VIP-LES/leos-ground-station-pcb/LEOS-ground-station.kicad_pcb

## KiCad design LEOS-ground-station.kicad_pcb (2026-10-07)

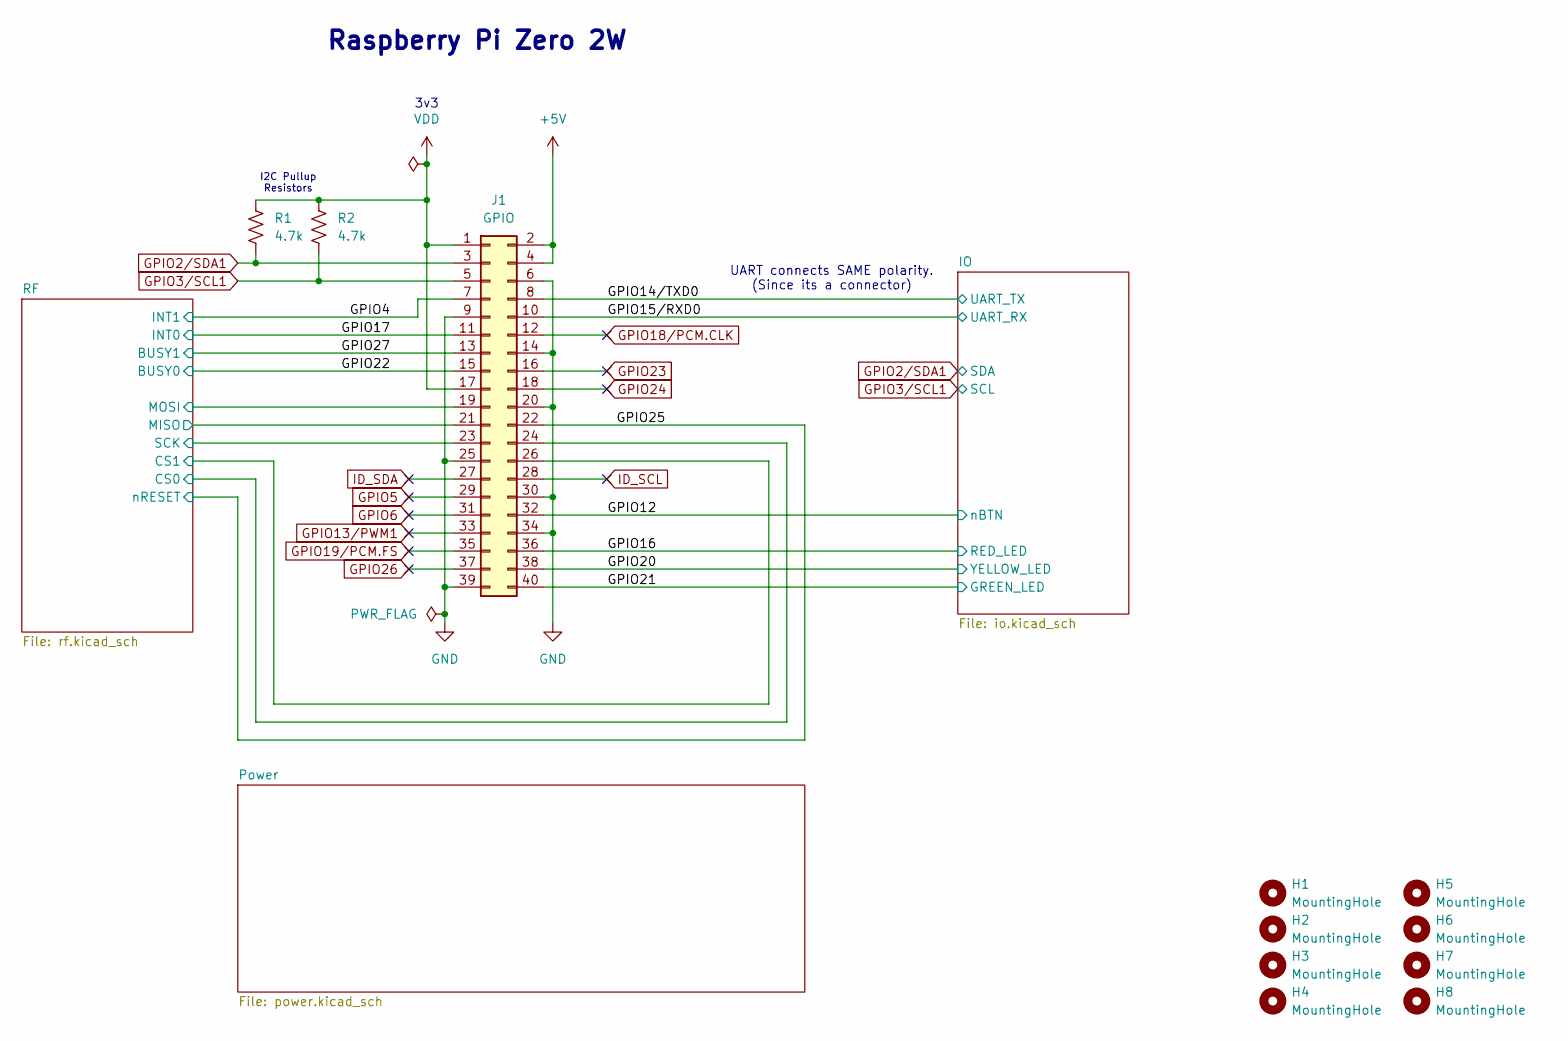
[picture p1: schematic LEOS-ground-station.kicad_sch, LEOS Ground Station]

Parts:
H1, H2, H3, H4: MountingHole; MountingHole_2.7mm_M2.5
H5, H6, H7, H8: MountingHole; MountingHole_3.2mm_M3
J1: GPIO; PinSocket_2x20_P2.54mm_Vertical
R1, R2: 4.7k; R_0805_2012Metric; MPN CRCW08054K70FKEA; Digikey 541-4.70KCCT-ND

Connections:
+5V: J1.2, J1.4; also elsewhere on the board
/GPIO4: J1.7; also elsewhere on the board
/GPIO12: J1.32; also elsewhere on the board
/GPIO14/TXD0: J1.8; also elsewhere on the board
/GPIO15/RXD0: J1.10; also elsewhere on the board
/GPIO16: J1.36; also elsewhere on the board
/GPIO17: J1.11; also elsewhere on the board
/GPIO20: J1.38; also elsewhere on the board
/GPIO21: J1.40; also elsewhere on the board
/GPIO22: J1.15; also elsewhere on the board
/GPIO25: J1.22; also elsewhere on the board
/GPIO27: J1.13; also elsewhere on the board
/RF/CS0: J1.24; also elsewhere on the board
/RF/CS1: J1.26; also elsewhere on the board
/RF/MISO: J1.21; also elsewhere on the board
/RF/MOSI: J1.19; also elsewhere on the board
/RF/SCK: J1.23; also elsewhere on the board
GND: J1.6, J1.9, J1.14, J1.20, J1.25, J1.30, J1.34, J1.39; also elsewhere on the board
GPIO2/SDA1: J1.3, R1.2; also elsewhere on the board
GPIO3/SCL1: J1.5, R2.2; also elsewhere on the board
GPIO5: J1.29
GPIO6: J1.31
GPIO13/PWM1: J1.33
GPIO18/PCM.CLK: J1.12
GPIO19/PCM.FS: J1.35
GPIO23: J1.16
GPIO24: J1.18
GPIO26: J1.37
ID_SCL: J1.28
ID_SDA: J1.27
VDD: J1.1, J1.17, R1.1, R2.1; also elsewhere on the board

Notes on the sheet:
3v3
Raspberry Pi Zero 2W
I2C Pullup Resistors
UART connects SAME polarity. (Since its a connector)

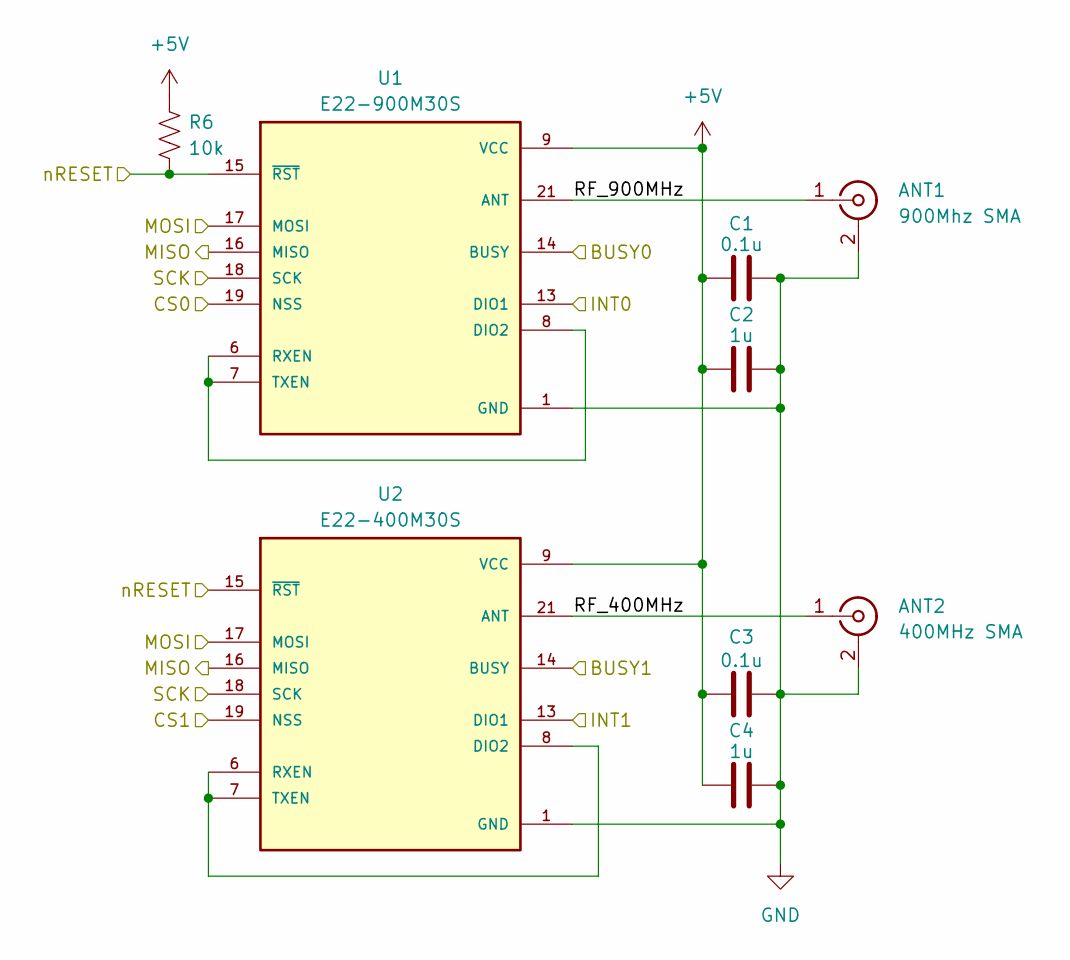
[picture p2: schematic rf.kicad_sch]

Parts:
ANT1: 900Mhz SMA; SMA_Molex_73251-1153_EdgeMount_Horizontal; MPN 0732511153; Digikey 900-0732511153-ND
ANT2: 400MHz SMA; SMA_Molex_73251-1153_EdgeMount_Horizontal; MPN 0732511153; Digikey 900-0732511153-ND
C1, C3: 0.1u; C_0603_1608Metric; MPN CL10B104KB8NNNL; Digikey 1276-CL10B104KB8NNNLCT-ND
C2, C4: 1u; C_0603_1608Metric; MPN CL10B105KA8NNNC; Digikey 1276-1184-1-ND
R6: 10k; R_0805_2012Metric; MPN CRCW080510K0FKEA; Digikey 541-10.0KCCT-ND
U1: E22-900M30S; XCVR_E22-900M30S; MPN E22-900M30S
U2: E22-400M30S; XCVR_E22-900M30S; MPN E22-400M30S

Connections:
+5V: C1.1, C2.1, C3.1, C4.1, R6.1, U1.9 (VCC), U1.10 (VCC), U2.9 (VCC), U2.10 (VCC); also elsewhere on the board
/GPIO4: U2.13 (DIO1); also elsewhere on the board
/GPIO17: U1.13 (DIO1); also elsewhere on the board
/GPIO22: U1.14 (BUSY); also elsewhere on the board
/GPIO25: R6.2, U1.15 (~RST), U2.15 (~RST); also elsewhere on the board
/GPIO27: U2.14 (BUSY); also elsewhere on the board
/RF/CS0: U1.19 (NSS); also elsewhere on the board
/RF/CS1: U2.19 (NSS); also elsewhere on the board
/RF/MISO: U1.16 (MISO), U2.16 (MISO); also elsewhere on the board
/RF/MOSI: U1.17 (MOSI), U2.17 (MOSI); also elsewhere on the board
/RF/RF_400MHz: ANT2.1 (In), U2.21 (ANT)
/RF/RF_900MHz: ANT1.1 (In), U1.21 (ANT)
/RF/SCK: U1.18 (SCK), U2.18 (SCK); also elsewhere on the board
GND: ANT1.2 (Ext), ANT2.2 (Ext), C1.2, C2.2, C3.2, C4.2, U1.1 (GND), U1.2 (GND), U1.3 (GND), U1.4 (GND), U1.5 (GND), U1.11 (GND), U1.12 (GND), U1.20 (GND), U1.22 (GND), U2.1 (GND), U2.2 (GND), U2.3 (GND), U2.4 (GND), U2.5 (GND), U2.11 (GND), U2.12 (GND), U2.20 (GND), U2.22 (GND); also elsewhere on the board
unnamed: U1.6 (RXEN), U1.7 (TXEN), U1.8 (DIO2)
unnamed: U2.6 (RXEN), U2.7 (TXEN), U2.8 (DIO2)

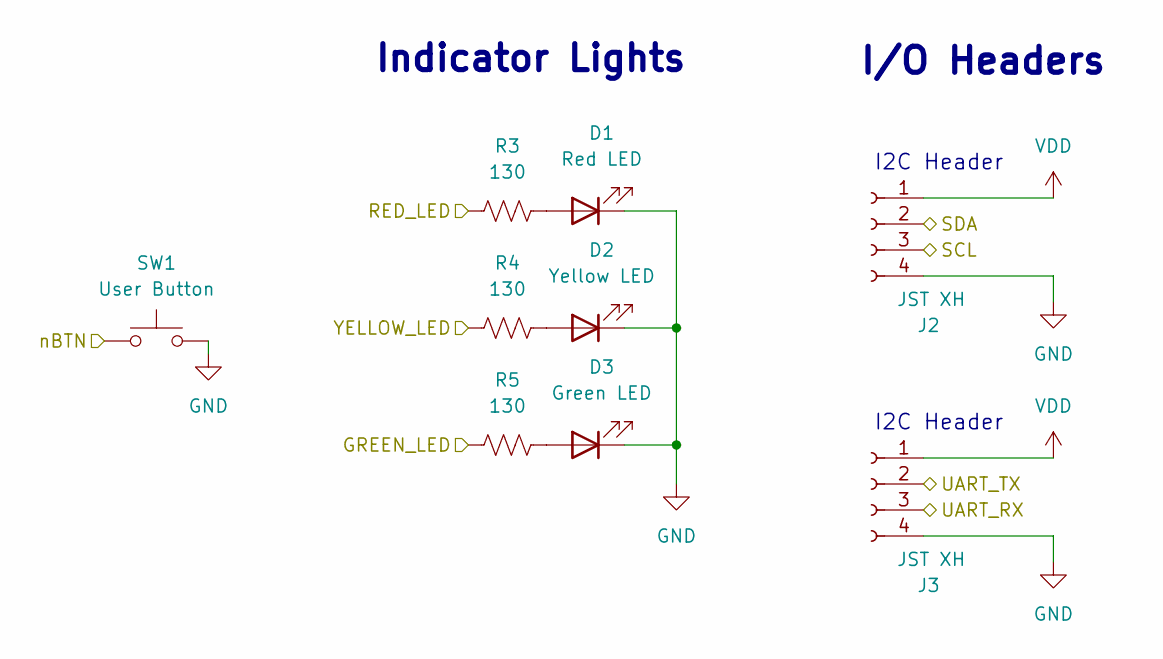
[picture p3: schematic io.kicad_sch]

Parts:
D1: Red LED; LED_1206_3216Metric; MPN LTST-C150KRKT; Digikey 160-1405-1-ND
D2: Yellow LED; LED_1206_3216Metric; MPN LTST-C150KSKT; Digikey 160-1406-1-ND
D3: Green LED; LED_1206_3216Metric; MPN LTST-C230KGKT; Digikey 160-1456-1-ND
J2, J3: JST XH; JST_XH_S4B-XH-A_1x04_P2.50mm_Horizontal; MPN S4B-XH-A; Digikey 455-2243-ND
R3, R4, R5: 130; R_0805_2012Metric; MPN CRCW0805130RFKEA; Digikey 541-130CCT-ND
SW1: User Button; SW_PUSH_6mm; MPN PTS645SK50-2 LFS; Digikey CKN9082-ND

Connections:
/GPIO12: SW1.1; also elsewhere on the board
/GPIO14/TXD0: J3.2; also elsewhere on the board
/GPIO15/RXD0: J3.3; also elsewhere on the board
/GPIO16: R3.1; also elsewhere on the board
/GPIO20: R4.1; also elsewhere on the board
/GPIO21: R5.1; also elsewhere on the board
GND: D1.1 (K), D2.1 (K), D3.1 (K), J2.4, J3.4, SW1.2; also elsewhere on the board
GPIO2/SDA1: J2.2; also elsewhere on the board
GPIO3/SCL1: J2.3; also elsewhere on the board
unnamed: D1.2 (A), R3.2
unnamed: D2.2 (A), R4.2
unnamed: D3.2 (A), R5.2
VDD: J2.1, J3.1; also elsewhere on the board

Notes on the sheet:
I2C Header
I/O Headers
Indicator Lights

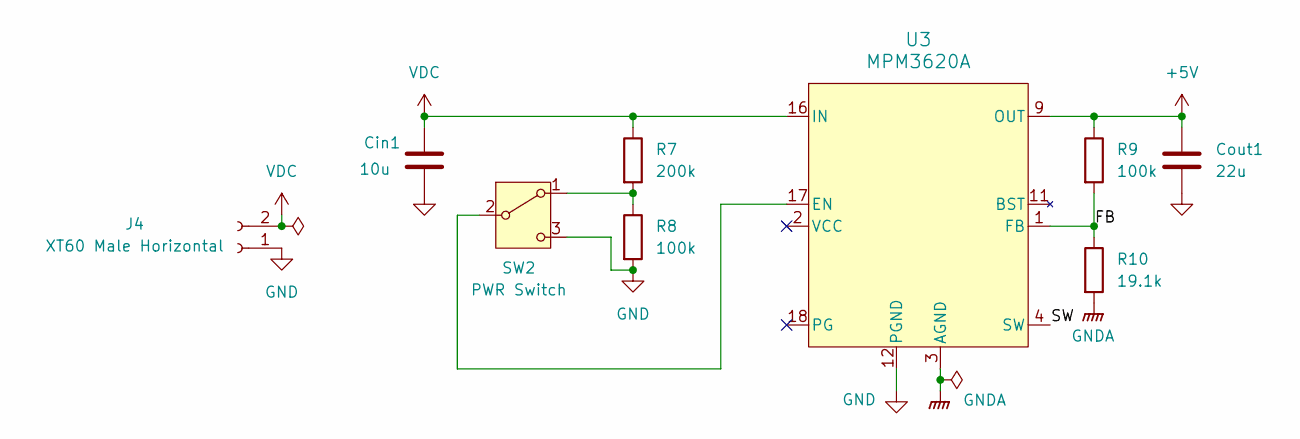
[picture p4: schematic power.kicad_sch]

Parts:
Cin1: 10u; C_0805_2012Metric; MPN CL21B106KOQNNNE; Digikey 1276-2872-1-ND
Cout1: 22u; C_0805_2012Metric; MPN CL21A226MAYNNNE; Digikey 1276-CL21A226MAYNNNECT-ND
J4: XT60 Male Horizontal; AMASS_XT60IPW-M_1x03_P7.20mm_Horizontal
R7: 200k; R_0805_2012Metric; MPN CRCW0805200KFKEA; Digikey 541-200KCCT-ND
R8, R9: 100k; R_0805_2012Metric; MPN CRCW0805100KFKEA; Digikey 541-100KCCT-ND
R10: 19.1k; R_0805_2012Metric; MPN CRCW080519K1FKEA; Digikey 541-19.1KCCT-ND
SW2: PWR Switch; SW_Slide_SPDT_Angled_CK_OS102011MA1Q; MPN OS102011MA1QN1; Digikey CKN9559-ND
U3: MPM3620A; IC18_MPM3620AGQV-Z_MNP; MPN MPM3620AGQV-Z; Digikey 1589-1764-1-ND

Connections:
+5V: Cout1.1, R9.1, U3.7 (OUT), U3.8 (OUT), U3.9 (OUT), U3.22 (OUT); also elsewhere on the board
/Power/FB: R9.2, R10.1, U3.1 (FB)
/Power/SW: U3.4 (SW), U3.5 (SW), U3.6 (SW), U3.21 (SW)
GND: Cin1.2, Cout1.2, J4.1, R8.2, SW2.3 (C), U3.12 (PGND), U3.13 (PGND), U3.14 (PGND); also elsewhere on the board
GNDA: R10.2, U3.3 (AGND)
unnamed: R7.2, R8.1, SW2.1 (A)
unnamed: SW2.2 (B), U3.17 (EN)
VDC: Cin1.1, J4.2, R7.1, U3.16 (IN)

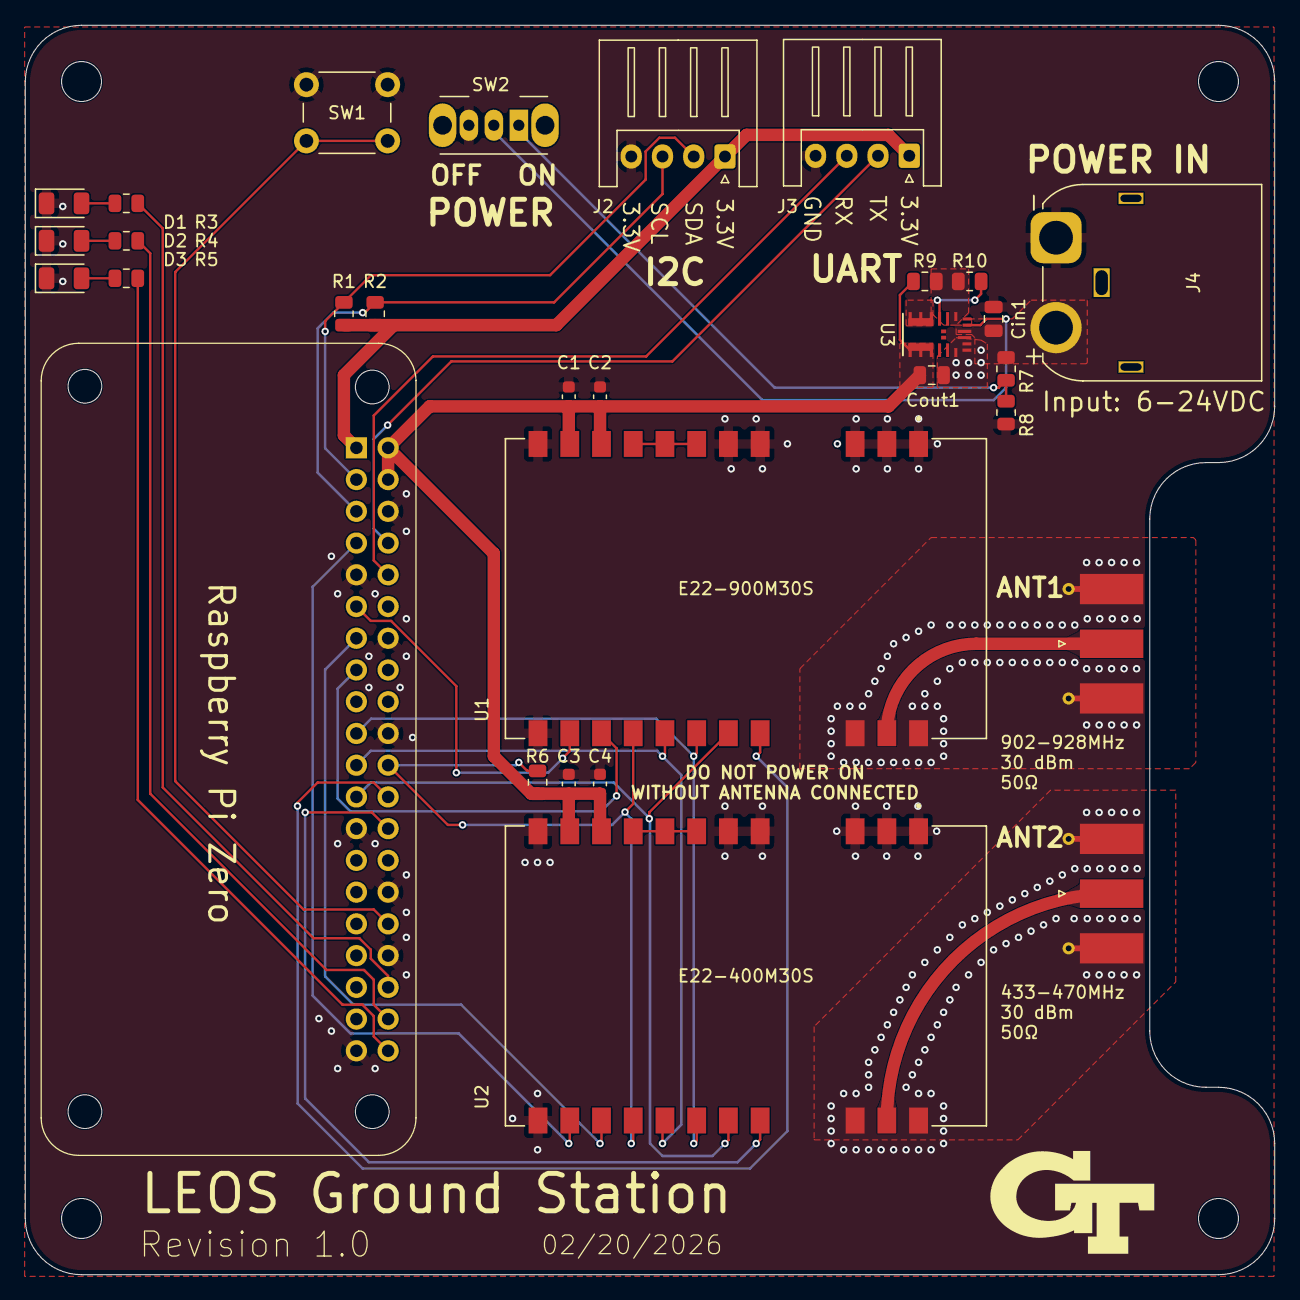
[picture p5: board LEOS-ground-station.kicad_pcb from above]

Board: 2 copper layers, 100.0 x 100.0 mm, 38 parts (1 on the bottom side), 34 nets.
