VIP-LES/leos-ground-station-pcb/(commit log)

2026-02-20 v1.0 Ground Station with buck power, rpi0, and dual LoRa
    [LEOS-ground-station.kicad_pcb, LEOS-ground-station.kicad_sch, LEOS-stack-template.kicad_pcb, LEOS-stack-template.kicad_sch, io.kicad_sch, power.kicad_sch, rf.kicad_sch]
2026-10-07 update to kicad 10
    [LEOS-ground-station.kicad_pcb, LEOS-ground-station.kicad_sch, io.kicad_sch, power.kicad_sch, rf.kicad_sch]
